nocoolnicksleft/fitepic/Images/500_fitepic-2.JPG

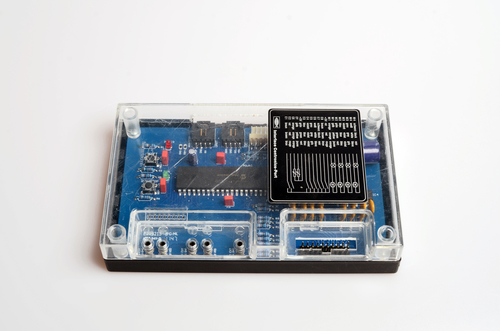
Images/500_fitepic-2.JPG
