nocoolnicksleft/fitepic/Images/500_fitepic-3.JPG

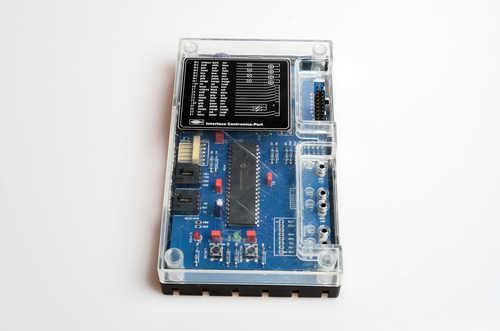
Images/500_fitepic-3.JPG
