nocoolnicksleft/fitepic/Images/500_fitepic-4.JPG

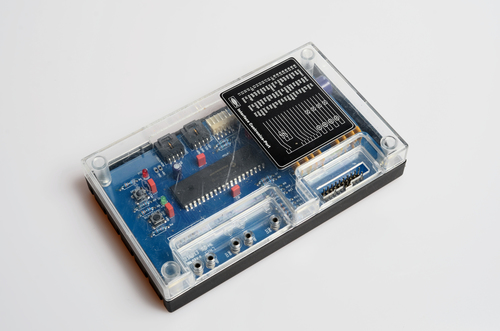
Images/500_fitepic-4.JPG
