nocoolnicksleft/fitepic/Images/fite-controller-1-main.sch-1.png

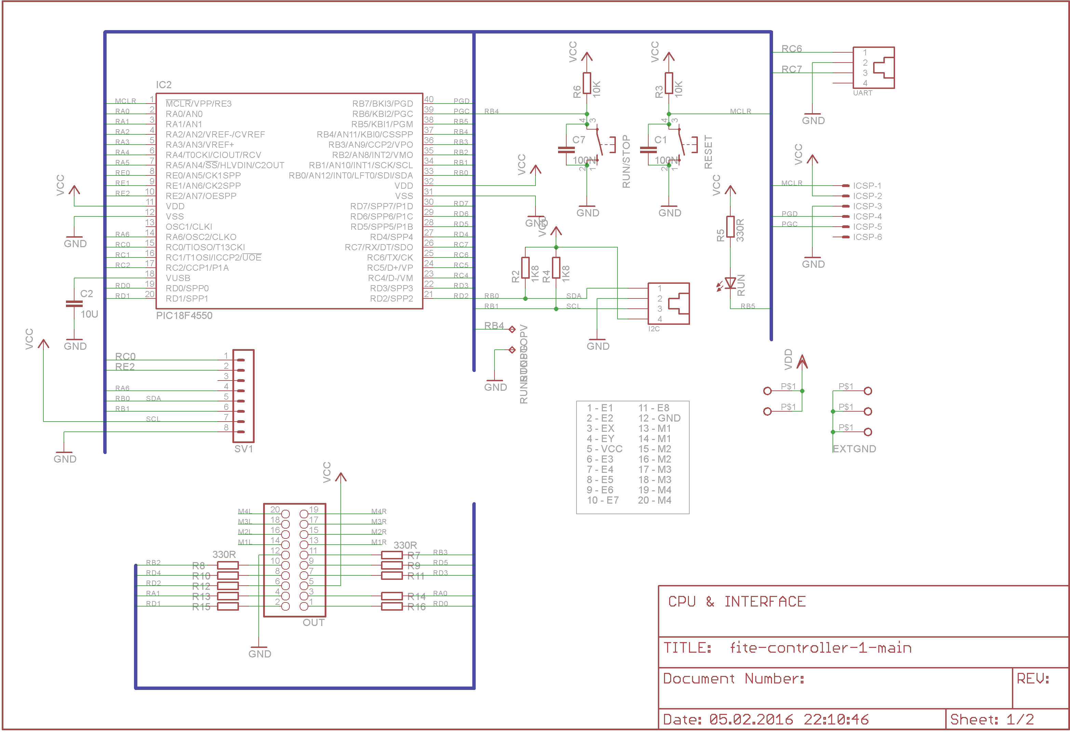
Images/fite-controller-1-main.sch-1.png
