nocoolnicksleft/fitepic/Images/fite-controller-1-main.sch-2.png

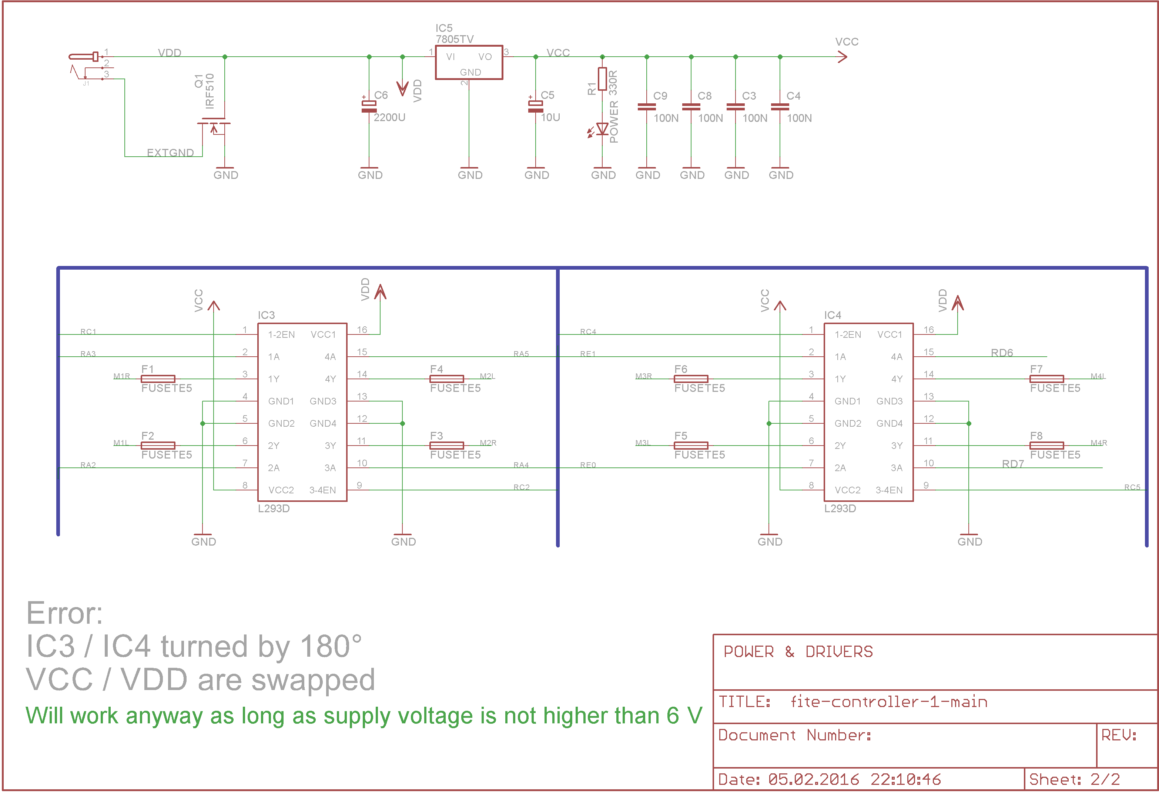
Images/fite-controller-1-main.sch-2.png
