nocoolnicksleft/fitepic/Board/fite-controller-1-main.sch

## EAGLE design Board/fite-controller-1-main.sch (2016-02-14)

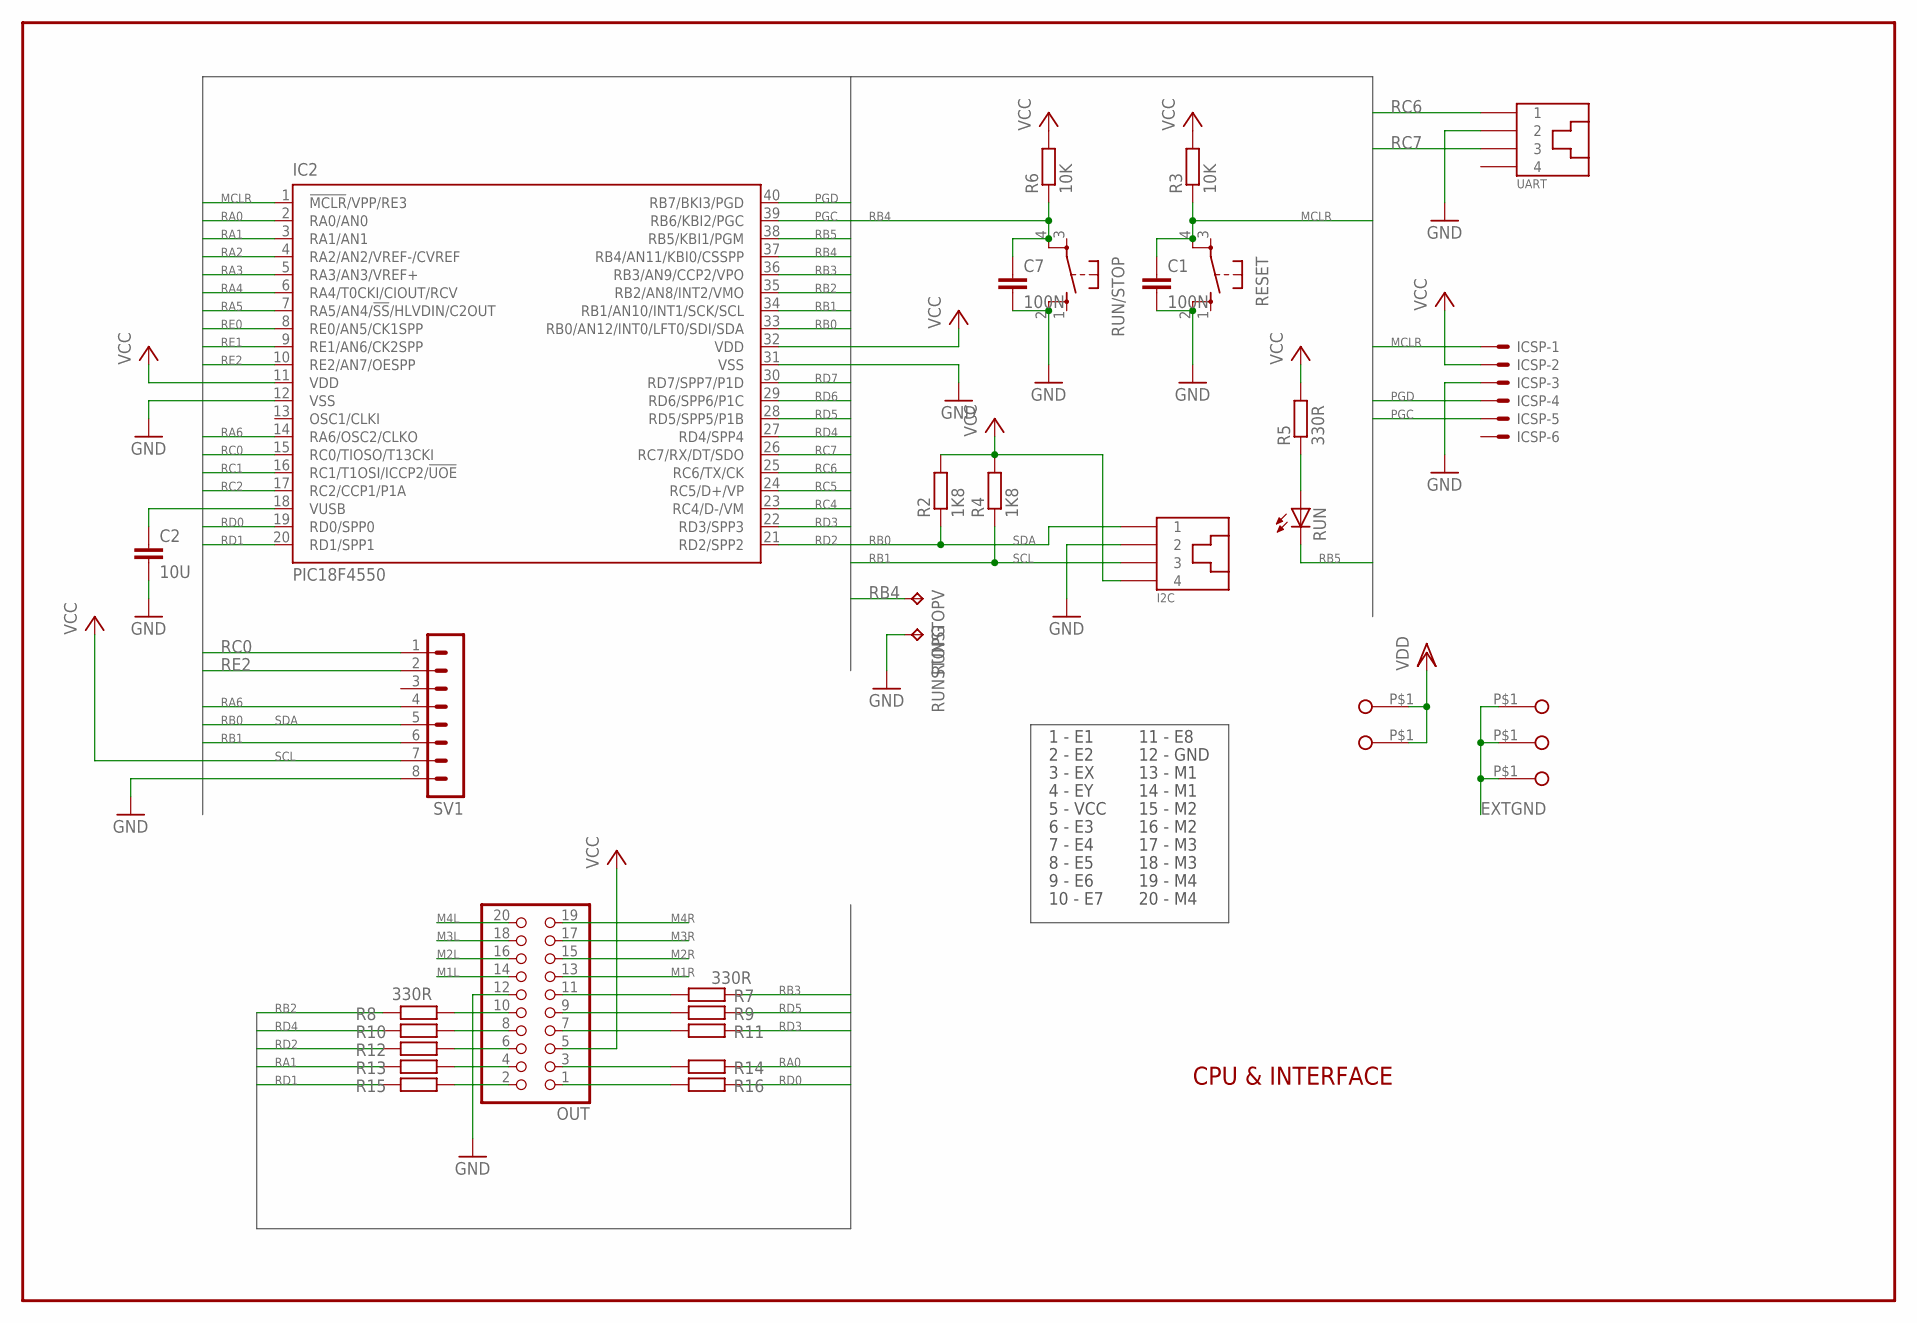
[picture p8: schematic fite-controller-1-main.sch, sheet 1]

Parts:
C1, C7: 100N; C025-025X050
C2: 10U; C025-025X050
I2C: PC_INTERNAL_AUDIO_4
IC2: PIC18F4550; DIL40
ICSP: 22-23-2061
OUT: PINHD-2X10; 2X10
R2, R4: 1K8; 0207/10
R3, R6: 10K; 0207/10
R5, R7, R8, R9, R10, R11, R12, R13, R14, R15, R16: 330R; 0207/10
RESET: 10XX; B3F-10XX
RUN: LED3MM
RUN/STOP: 10XX; B3F-10XX
RUNSTOPG: TPPAD1-13Y; P1-13Y
RUNSTOPV: TPPAD1-13Y; P1-13Y
SV1: MA08-1
UART: PC_INTERNAL_AUDIO_4
VBB_GND_1: FITE_HUELSE; HUELSE_3.2MM
VDD_1, VDD_2: FITE_HUELSE; HUELSE_3.2MM
VDD_GND: FITE_HUELSE; HUELSE_3.2MM
VDD_GND_2: FITE_HUELSE; HUELSE_3.2MM

Connections:
EXTGND: VBB_GND_1.P$1, VDD_GND.P$1, VDD_GND_2.P$1
GND: C1.2, C2.2, C7.2, I2C.P$2 (2), IC2.12 (VSS), IC2.31 (VSS), ICSP.3, OUT.12, RESET.2, RUN/STOP.2, RUNSTOPG.TP, SV1.8, UART.P$2 (2)
LEDRUN-01: R5.1, RUN.A
M1L: OUT.14
M1R: OUT.13
M2L: OUT.16
M2R: OUT.15
M3L: OUT.18
M3R: OUT.17
M4L: OUT.20
M4R: OUT.19
MCLR: C1.1, IC2.1 (!MCLR!/VPP/RE3), ICSP.1, R3.1, RESET.4
unnamed: C2.1, IC2.18 (VUSB)
unnamed: OUT.10, R8.1
unnamed: OUT.8, R10.1
unnamed: OUT.6, R12.1
unnamed: OUT.4, R13.2
unnamed: OUT.2, R15.1
unnamed: OUT.11, R7.2
unnamed: OUT.9, R9.2
unnamed: OUT.7, R11.2
unnamed: OUT.3, R14.2
unnamed: OUT.1, R16.2
PGC: IC2.39 (RB6/KBI2/PGC), ICSP.5
PGD: IC2.40 (RB7/BKI3/PGD), ICSP.4
RA0: IC2.2 (RA0/AN0), R14.1
RA1: IC2.3 (RA1/AN1), R13.1
RA2: IC2.4 (RA2/AN2/VREF-/CVREF)
RA3: IC2.5 (RA3/AN3/VREF+)
RA4: IC2.6 (RA4/T0CKI/CIOUT/RCV)
RA5: IC2.7 (RA5/AN4/!SS!/HLVDIN/C2OUT)
RA6: IC2.14 (RA6/OSC2/CLKO), SV1.4
RB0: I2C.P$1 (1), IC2.33 (RB0/AN12/INT0/LFT0/SDI/SDA), R2.1, SV1.5
RB1: I2C.P$3 (3), IC2.34 (RB1/AN10/INT1/SCK/SCL), R4.1, SV1.6
RB2: IC2.35 (RB2/AN8/INT2/VMO), R8.2
RB3: IC2.36 (RB3/AN9/CCP2/VPO), R7.1
RB4: C7.1, IC2.37 (RB4/AN11/KBI0/CSSPP), R6.1, RUN/STOP.4, RUNSTOPV.TP
RB5: IC2.38 (RB5/KBI1/PGM), RUN.K (C)
RC0: IC2.15 (RC0/TIOSO/T13CKI), SV1.1
RC1: IC2.16 (RC1/T1OSI/ICCP2/!UOE)
RC2: IC2.17 (RC2/CCP1/P1A)
RC4: IC2.23 (RC4/D-/VM)
RC5: IC2.24 (RC5/D+/VP)
RC6: IC2.25 (RC6/TX/CK), UART.P$1 (1)
RC7: IC2.26 (RC7/RX/DT/SDO), UART.P$3 (3)
RD0: IC2.19 (RD0/SPP0), R16.1
RD1: IC2.20 (RD1/SPP1), R15.2
RD2: IC2.21 (RD2/SPP2), R12.2
RD3: IC2.22 (RD3/SPP3), R11.1
RD4: IC2.27 (RD4/SPP4), R10.2
RD5: IC2.28 (RD5/SPP5/P1B), R9.1
RD6: IC2.29 (RD6/SPP6/P1C)
RD7: IC2.30 (RD7/SPP7/P1D)
RE0: IC2.8 (RE0/AN5/CK1SPP)
RE1: IC2.9 (RE1/AN6/CK2SPP)
RE2: IC2.10 (RE2/AN7/OESPP), SV1.2
VCC: I2C.P$4 (4), IC2.11 (VDD), IC2.32 (VDD), ICSP.2, OUT.5, R2.2, R3.2, R4.2, R5.2, R6.2, SV1.7
VDD: VDD_1.P$1, VDD_2.P$1

Notes on the sheet:
1 - E1
2 - E2
3 - EX
4 - EY
5 - VCC
6 - E3
7 - E4
8 - E5
9 - E6
10 - E7
11 - E8
12 - GND
13 - M1
14 - M1
15 - M2
16 - M2
17 - M3
18 - M3
19 - M4
20 - M4
CPU & INTERFACE
SDA
SCL

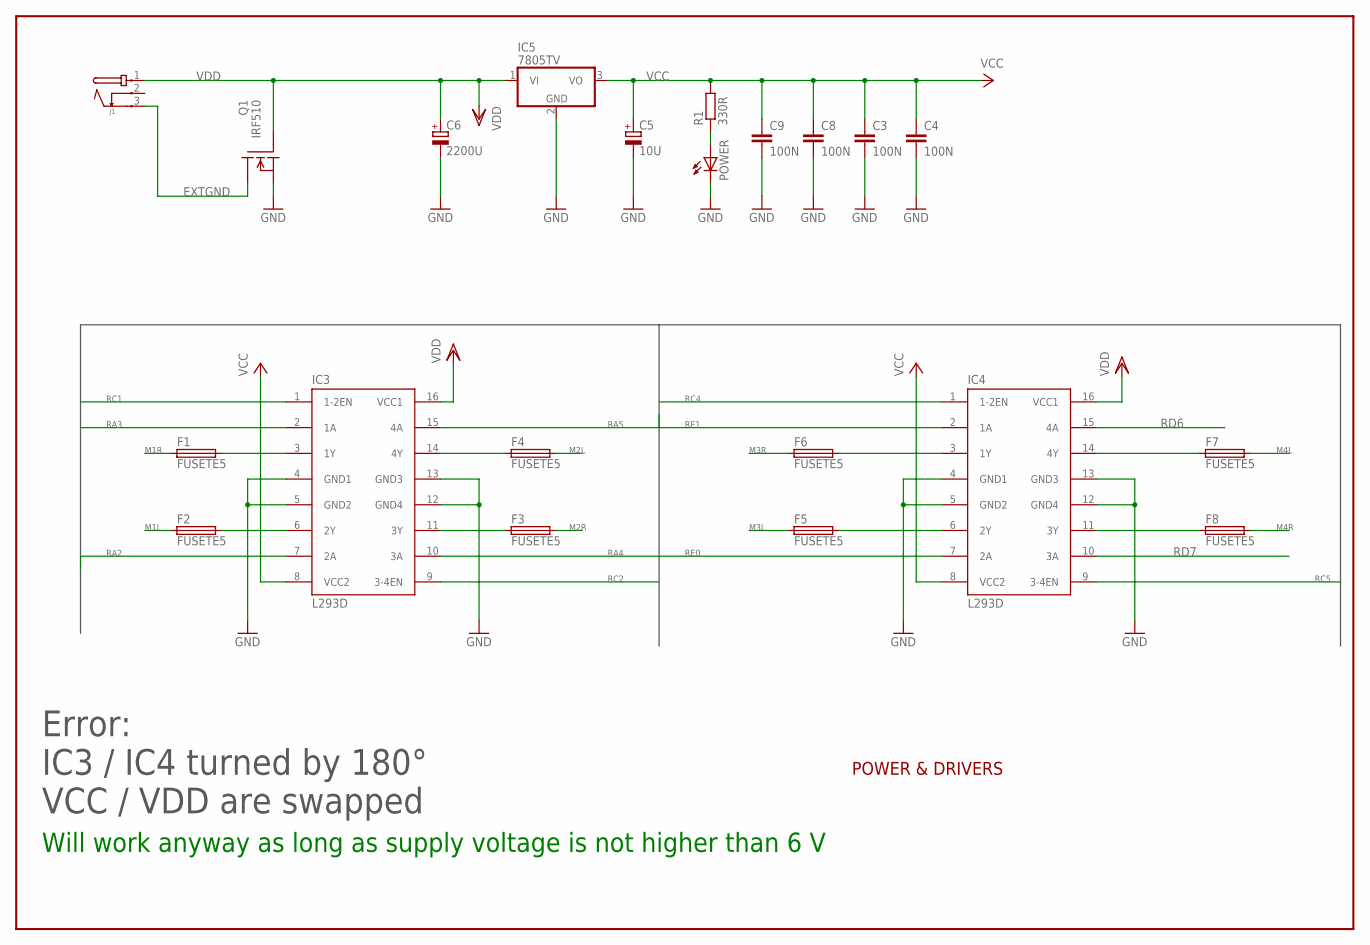
[picture p9: schematic fite-controller-1-main.sch, sheet 2]

Parts:
C3, C4, C8, C9: 100N; C025-025X050
C5: 10U; E2-4
C6: 2200U; E3,5-10
F1, F2, F3, F4, F5, F6, F7, F8: FUSETE5; TE5
IC3, IC4: L293D; DIL16
IC5: 7805TV; TO220V
J1: JACK-PMS
POWER: LED3MM
Q1: IRF510; TO220
R1: 330R; 0207/10

Connections:
EXTGND: J1.3, Q1.2 (D)
GND: C3.2, C4.2, C5.-, C6.-, C8.2, C9.2, IC3.4 (GND1), IC3.5 (GND2), IC3.12 (GND4), IC3.13 (GND3), IC4.4 (GND1), IC4.5 (GND2), IC4.12 (GND4), IC4.13 (GND3), IC5.2 (GND), POWER.K (C), Q1.3 (S)
LEDPWR-01: POWER.A, R1.1
M1L: F2.1
M1L-01: F2.2, IC3.6 (2Y)
M1R: F1.1
M1R-01: F1.2, IC3.3 (1Y)
M2L: F4.2
M2L-01: F4.1, IC3.14 (4Y)
M2R: F3.2
M2R-01: F3.1, IC3.11 (3Y)
M3L: F5.1
M3L-01: F5.2, IC4.6 (2Y)
M3R: F6.1
M3R-01: F6.2, IC4.3 (1Y)
M4L: F7.2
M4L-01: F7.1, IC4.14 (4Y)
M4R: F8.2
M4R-01: F8.1, IC4.11 (3Y)
RA2: IC3.7 (2A)
RA3: IC3.2 (1A)
RA4: IC3.10 (3A)
RA5: IC3.15 (4A)
RC1: IC3.1 (1-2EN)
RC2: IC3.9 (3-4EN)
RC4: IC4.1 (1-2EN)
RC5: IC4.9 (3-4EN)
RD6: IC4.15 (4A)
RD7: IC4.10 (3A)
RE0: IC4.7 (2A)
RE1: IC4.2 (1A)
VCC: C3.1, C4.1, C5.+, C8.1, C9.1, IC3.8 (VCC2), IC4.8 (VCC2), IC5.3 (VO), R1.2
VDD: C6.+, IC3.16 (VCC1), IC4.16 (VCC1), IC5.1 (VI), J1.1, Q1.1 (G)

Notes on the sheet:
POWER & DRIVERS
Error:
IC3 / IC4 turned by 180°
VCC / VDD are swapped
Will work anyway as long as supply voltage is not higher than 6 V
